haris-mujeeb/STM32-Drone-Controller/README.md

# 🚁 STM32 Drone Controller 🚀

A compact and robust drone flight controller designed with STM32 microcontroller and KiCad. This project focuses on providing a reliable hardware platform for custom drone builds and research.

## ✨ Features

*   **STM32 Microcontroller**: High-performance processing for flight control algorithms.
*   **BMI088 IMU**: Integrated 6-axis Inertial Measurement Unit for precise attitude estimation.
*   **KiCad Design**: Open-source hardware design files for easy modification and manufacturing.

## 🛠️ Technologies Used

*   **KiCad**: PCB design and schematic capture.
*   **STM32**: Embedded system development.
*   **BMI088**: Sensor integration.

## 📸 Visuals
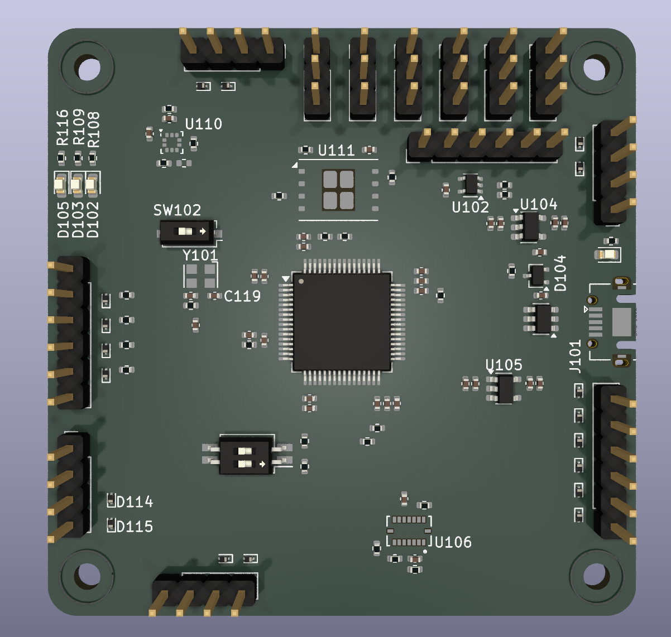
[picture p1: PCB_1.png]


## 📍Pinout
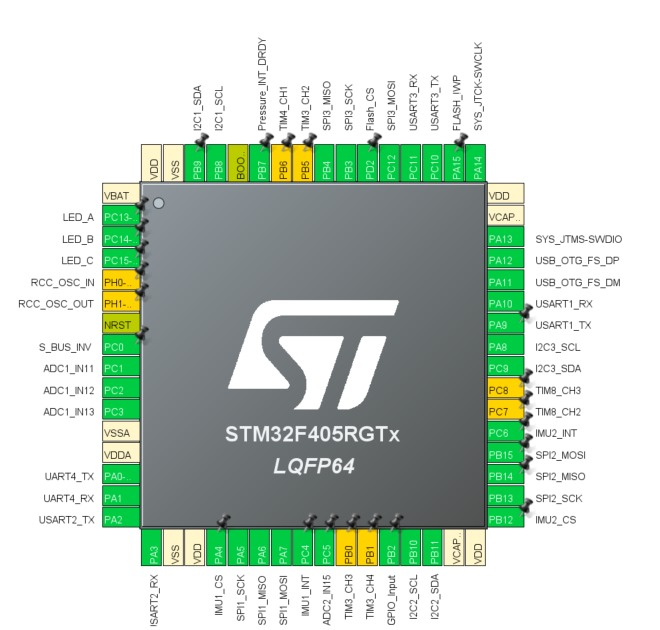
[picture p2: STM32 Pinout.jpg]
STM32 Drone Controller Pinout


## 📄Schematic
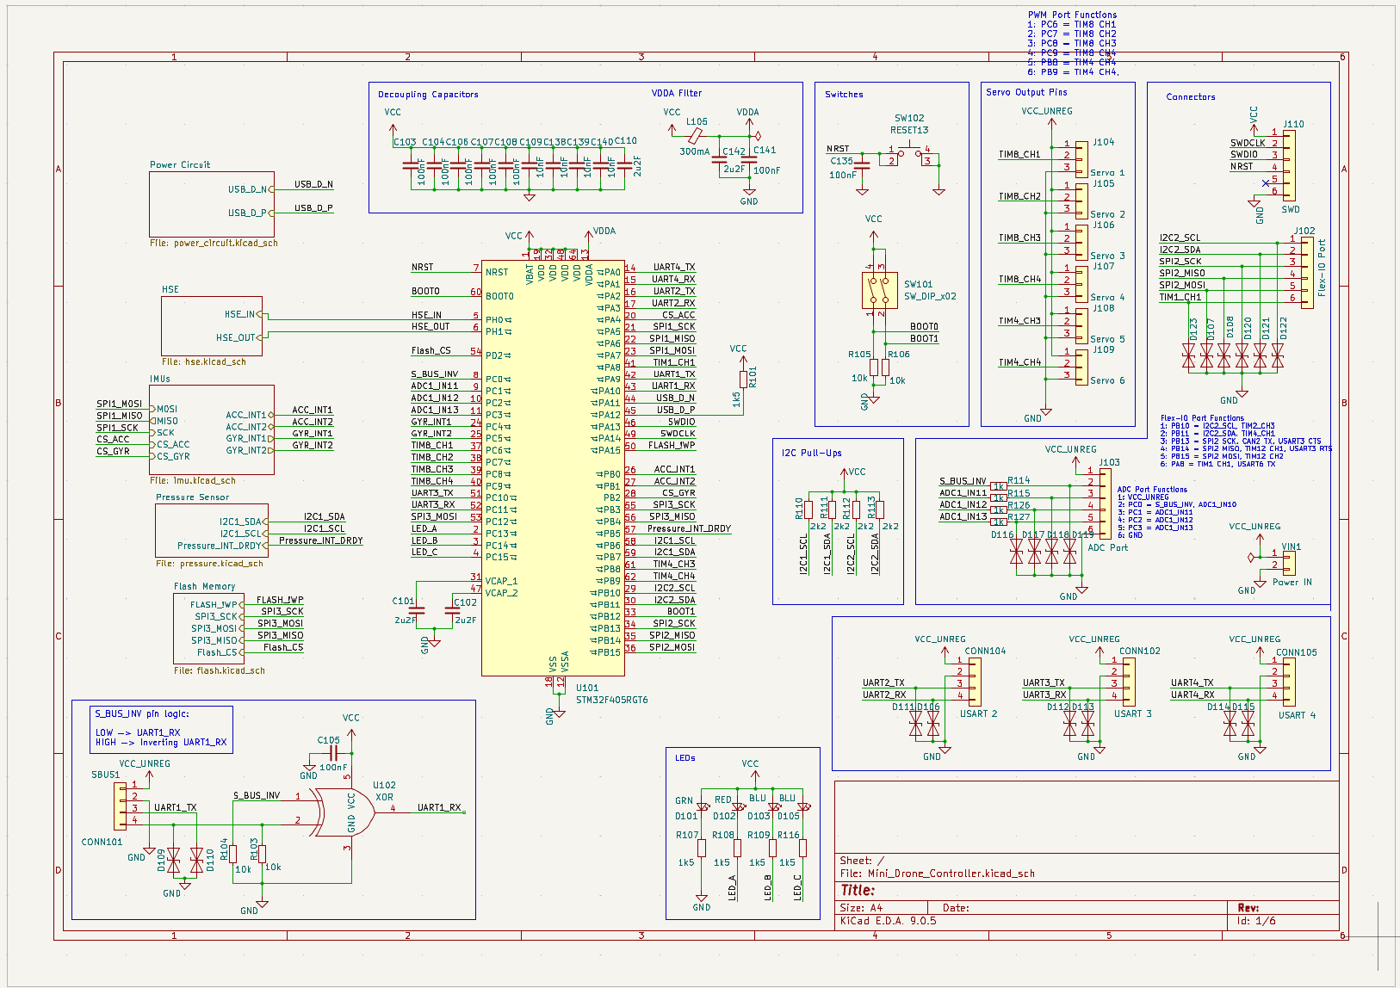
[picture p3: Schematic.png]
STM32 Drone Controller Schematic


## 📂 Project Structure

The repository contains all necessary KiCad project files, component libraries, and documentation.
