haris-mujeeb/STM32-Drone-Controller/Components/BMI088/BMI088.step

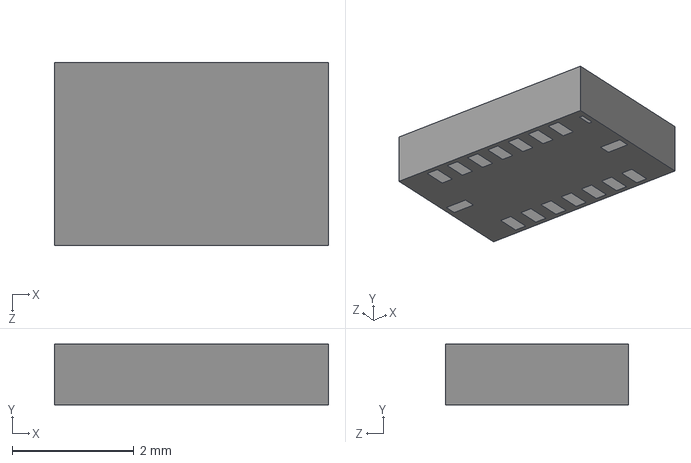
[picture p4: CAD file, 2025-10-25]
Components/BMI088/BMI088.step
4.50 x 1.00 x 3.00 mm
