haris-mujeeb/STM32-Drone-Controller/Mini_Drone_Controller.kicad_pcb

## KiCad design Mini_Drone_Controller.kicad_pcb (2025-10-25)

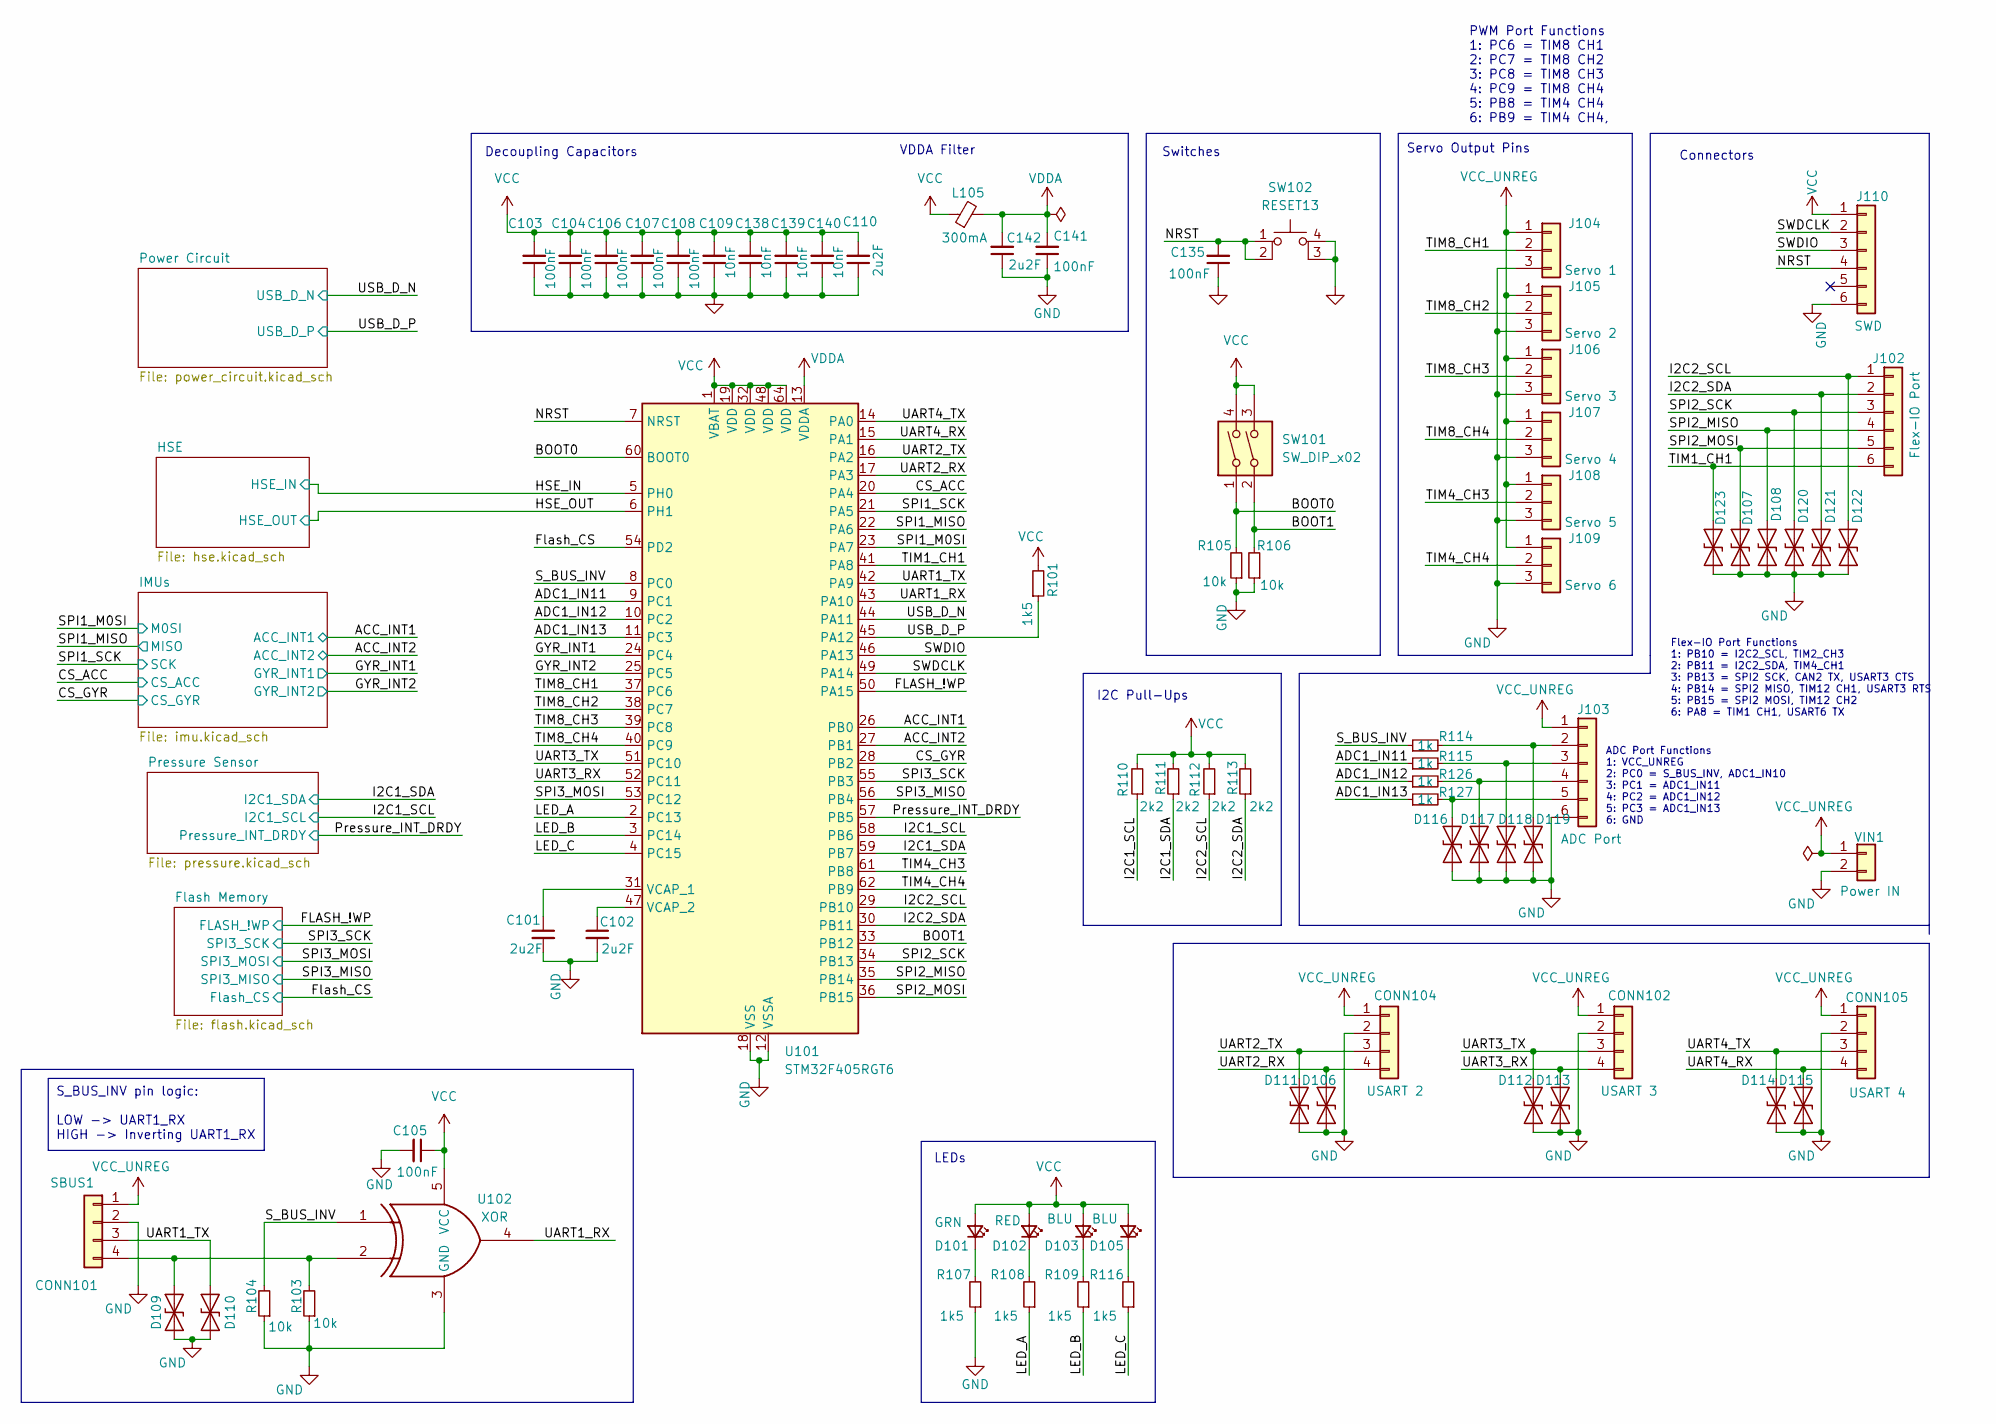
[picture p5: schematic Mini_Drone_Controller.kicad_sch]

Parts:
C101, C102, C110, C142: 2u2F; C_0402_1005Metric; Mfr. # CL05A225MQ5NSNC
C103, C104, C105, C106, C107, C108, C135, C141: 100nF; C_0402_1005Metric; Mfr. # CL05B104KO5NNNC
C109, C138, C139, C140: 10nF; C_0402_1005Metric; Mfr. # CL05B103KB5NNNC
CONN101: SBUS1; PinHeader_1x04_P2.54mm_Vertical; Mfr. # HB-PH3-25414PB2GOP
CONN102: USART 3; PinHeader_1x04_P2.54mm_Vertical; Mfr. # HB-PH3-25414PB2GOP
CONN104: USART 2; PinHeader_1x04_P2.54mm_Vertical; Mfr. # HB-PH3-25414PB2GOP
CONN105: USART 4; PinHeader_1x04_P2.54mm_Vertical; Mfr. # HB-PH3-25414PB2GOP
D101: GRN; LED_0603_1608Metric; Mfr. # PSC-1608U52GC-G4
D102: RED; LED_0603_1608Metric; Mfr. # XL-1608SURC-06
D103, D105: BLU; LED_0603_1608Metric; Mfr. # XL-1608UBC-04
D106, D107, D108, D109, D110, D111, D112, D113, D114, D115, D116, D117, D118, D119, D120, D121, D122, D123: ESD9B3.3ST5G; D_SOD-923; Mfr. # ESD9B3.3ST5G
J102: Flex-IO Port; PinHeader_1x06_P2.54mm_Vertical; Mfr. # PZ254V-11-06P
J103: ADC Port; PinHeader_1x06_P2.54mm_Vertical; Mfr. # PZ254V-11-06P
J104: Servo 1; PinHeader_1x03_P2.54mm_Vertical; Mfr. # 2.54-1*3P
J105: Servo 2; PinHeader_1x03_P2.54mm_Vertical; Mfr. # 2.54-1*3P
J106: Servo 3; PinHeader_1x03_P2.54mm_Vertical; Mfr. # 2.54-1*3P
J107: Servo 4; PinHeader_1x03_P2.54mm_Vertical; Mfr. # 2.54-1*3P
J108: Servo 5; PinHeader_1x03_P2.54mm_Vertical; Mfr. # 2.54-1*3P
J109: Servo 6; PinHeader_1x03_P2.54mm_Vertical; Mfr. # 2.54-1*3P
J110: SWD; PinHeader_1x06_P2.54mm_Vertical; Mfr. # PZ254V-11-06P
L105: 300mA; R_0402_1005Metric; Mfr. # BLM15AG102SN1D
R101, R107, R108, R109, R116: 1k5; R_0402_1005Metric; Mfr. # RC0402FR-071K5L
R103, R104, R105, R106: 10k; R_0402_1005Metric; Mfr. # RC0402FR-0710KL
R110, R111, R112, R113: 2k2; R_0402_1005Metric; Mfr. # RC0402FR-072K2L
R114, R115, R126, R127: 1k; R_0402_1005Metric; Mfr. # RC0402FR-071KL
SW101: SW_DIP_x02; SW_DIP_SPSTx02_Slide_Copal_CHS-02B_W7.62mm_P1.27mm; Mfr. # DSHP02TSGET
SW102: RESET13; SW_DIP_SPSTx01_Slide_Copal_CHS-01A_W5.08mm_P1.27mm_JPin; Mfr. # TS-1088-AR02016
U101: STM32F405RGT6; LQFP-64_10x10mm_P0.5mm; Mfr. # STM32F405RGT6
U102: XOR; SOT-353_SC-70-5; Mfr. # SN74LVC1G86DCKR
VIN1: Power IN; PinHeader_1x02_P2.54mm_Vertical; Mfr. # PZ254V-11-02P

Connections:
/ACC_INT1: U101.26 (PB0); also elsewhere on the board
/ACC_INT2: U101.27 (PB1); also elsewhere on the board
/ADC1_IN11: R115.1, U101.9 (PC1)
/ADC1_IN12: R126.1, U101.10 (PC2)
/ADC1_IN13: R127.1, U101.11 (PC3)
/BOOT0: R105.2, SW101.1, U101.60 (BOOT0)
/BOOT1: R106.2, SW101.2, U101.33 (PB12)
/CS_ACC: U101.20 (PA4); also elsewhere on the board
/CS_GYR: U101.28 (PB2); also elsewhere on the board
/FLASH_!WP: U101.50 (PA15); also elsewhere on the board
/Flash_CS: U101.54 (PD2); also elsewhere on the board
/GYR_INT1: U101.24 (PC4); also elsewhere on the board
/GYR_INT2: U101.25 (PC5); also elsewhere on the board
/HSE_IN: U101.5 (PH0); also elsewhere on the board
/HSE_OUT: U101.6 (PH1); also elsewhere on the board
/I2C1_SCL: R110.1, U101.58 (PB6); also elsewhere on the board
/I2C1_SDA: R111.1, U101.59 (PB7); also elsewhere on the board
/I2C2_SCL: D122.2 (A2), J102.1, R112.1, U101.29 (PB10)
/I2C2_SDA: D121.2 (A2), J102.2, R113.1, U101.30 (PB11)
/LED_A: R108.1, U101.2 (PC13)
/LED_B: R109.1, U101.3 (PC14)
/LED_C: R116.1, U101.4 (PC15)
/NRST: C135.2, J110.4, SW102.1, SW102.2, U101.7 (NRST)
/Pressure_INT_DRDY: U101.57 (PB5); also elsewhere on the board
/SPI1_M0SI: U101.23 (PA7); also elsewhere on the board
/SPI1_MISO: U101.22 (PA6); also elsewhere on the board
/SPI1_SCK: U101.21 (PA5); also elsewhere on the board
/SPI2_MISO: D108.2 (A2), J102.4, U101.35 (PB14)
/SPI2_MOSI: D107.2 (A2), J102.5, U101.36 (PB15)
/SPI2_SCK: D120.2 (A2), J102.3, U101.34 (PB13)
/SPI3_MISO: U101.56 (PB4); also elsewhere on the board
/SPI3_MOSI: U101.53 (PC12); also elsewhere on the board
/SPI3_SCK: U101.55 (PB3); also elsewhere on the board
/SWDCLK: J110.2, U101.49 (PA14)
/SWDIO: J110.3, U101.46 (PA13)
/S_BUS_INV: R104.2, R114.1, U101.8 (PC0), U102.1
/TIM1_CH1: D123.2 (A2), J102.6, U101.41 (PA8)
/TIM4_CH3: J108.2, U101.61 (PB8)
/TIM4_CH4: J109.2, U101.62 (PB9)
/TIM8_CH1: J104.2, U101.37 (PC6)
/TIM8_CH2: J105.2, U101.38 (PC7)
/TIM8_CH3: J106.2, U101.39 (PC8)
/TIM8_CH4: J107.2, U101.40 (PC9)
/UART1_RX: U101.43 (PA10), U102.4
/UART1_TX: CONN101.3, D110.2 (A2), U101.42 (PA9)
/UART2_RX: CONN104.4, D106.2 (A2), U101.17 (PA3)
/UART2_TX: CONN104.3, D111.2 (A2), U101.16 (PA2)
/UART3_RX: CONN102.4, D113.2 (A2), U101.52 (PC11)
/UART3_TX: CONN102.3, D112.2 (A2), U101.51 (PC10)
/UART4_RX: CONN105.4, D115.2 (A2), U101.15 (PA1)
/UART4_TX: CONN105.3, D114.2 (A2), U101.14 (PA0)
/USB_D_N: U101.44 (PA11); also elsewhere on the board
/USB_D_P: R101.1, U101.45 (PA12); also elsewhere on the board
GND: C101.2, C102.2, C103.1, C104.1, C105.2, C106.1, C107.1, C108.1, C109.1, C110.1, C135.1, C138.1, C139.1, C140.1, C141.1, C142.1, CONN101.2, CONN102.2, CONN104.2, CONN105.2, D106.1 (A1), D107.1 (A1), D108.1 (A1), D109.1 (A1), D110.1 (A1), D111.1 (A1), D112.1 (A1), D113.1 (A1), D114.1 (A1), D115.1 (A1), D116.1 (A1), D117.1 (A1), D118.1 (A1), D119.1 (A1), D120.1 (A1), D121.1 (A1), D122.1 (A1), D123.1 (A1), J103.6, J104.3, J105.3, J106.3, J107.3, J108.3, J109.3, J110.6, R103.1, R104.1, R105.1, R106.1, R107.1, SW102.3 (K), SW102.4 (A), U101.12 (VSSA), U101.18 (VSS), U101.63 (VSS), U102.3 (GND), VIN1.2; also elsewhere on the board
unnamed: CONN101.4, D109.2 (A2), R103.2, U102.2
unnamed: D101.1 (K), R107.2
unnamed: D102.1 (K), R108.2
unnamed: D103.1 (K), R109.2
unnamed: D105.1 (K), R116.2
unnamed: D116.2 (A2), J103.5, R127.2
unnamed: D117.2 (A2), J103.4, R126.2
unnamed: D118.2 (A2), J103.3, R115.2
unnamed: D119.2 (A2), J103.2, R114.2
unnamed: C101.1, U101.31 (VCAP_1)
unnamed: C102.1, U101.47 (VCAP_2)
VCC: C103.2, C104.2, C105.1, C106.2, C107.2, C108.2, C109.2, C110.2, C138.2, C139.2, C140.2, D101.2 (A), D102.2 (A), D103.2 (A), D105.2 (A), J110.1, L105.1, R101.2, R110.2, R111.2, R112.2, R113.2, SW101.3, SW101.4, U101.1 (VBAT), U101.19 (VDD), U101.32 (VDD), U101.48 (VDD), U101.64 (VDD), U102.5 (VCC); also elsewhere on the board
VCC_UNREG: CONN101.1, CONN102.1, CONN104.1, CONN105.1, J103.1, J104.1, J105.1, J106.1, J107.1, J108.1, J109.1, VIN1.1; also elsewhere on the board
VDDA: C141.2, C142.2, L105.2, U101.13 (VDDA)

Notes on the sheet:
S_BUS_INV pin logic: LOW -> UART1_RX HIGH -> Inverting UART1_RX
LEDs
Switches
Connectors
Decoupling Capacitors
VDDA Filter
Flex-IO Port Functions 1: PB10 = I2C2_SCL, TIM2_CH3 2: PB11 = I2C2_SDA, TIM4_CH1 3: PB13 = SPI2 SCK, CAN2 TX, USART3 CTS 4: PB14 = SPI2 MISO, TIM12 CH1, USART3 RTS 5: PB15 = SPI2 MOSI, TIM12 CH2 6: PA8 = TIM1 CH1, USART6 TX
I2C Pull-Ups
PWM Port Functions 1: PC6 = TIM8 CH1 2: PC7 = TIM8 CH2 3: PC8 = TIM8 CH3 4: PC9 = TIM8 CH4 5: PB8 = TIM4 CH4 6: PB9 = TIM4 CH4,
ADC Port Functions 1: VCC_UNREG 2: PC0 = S_BUS_INV, ADC1_IN10 3: PC1 = ADC1_IN11 4: PC2 = ADC1_IN12 5: PC3 = ADC1_IN13 6: GND
Servo Output Pins

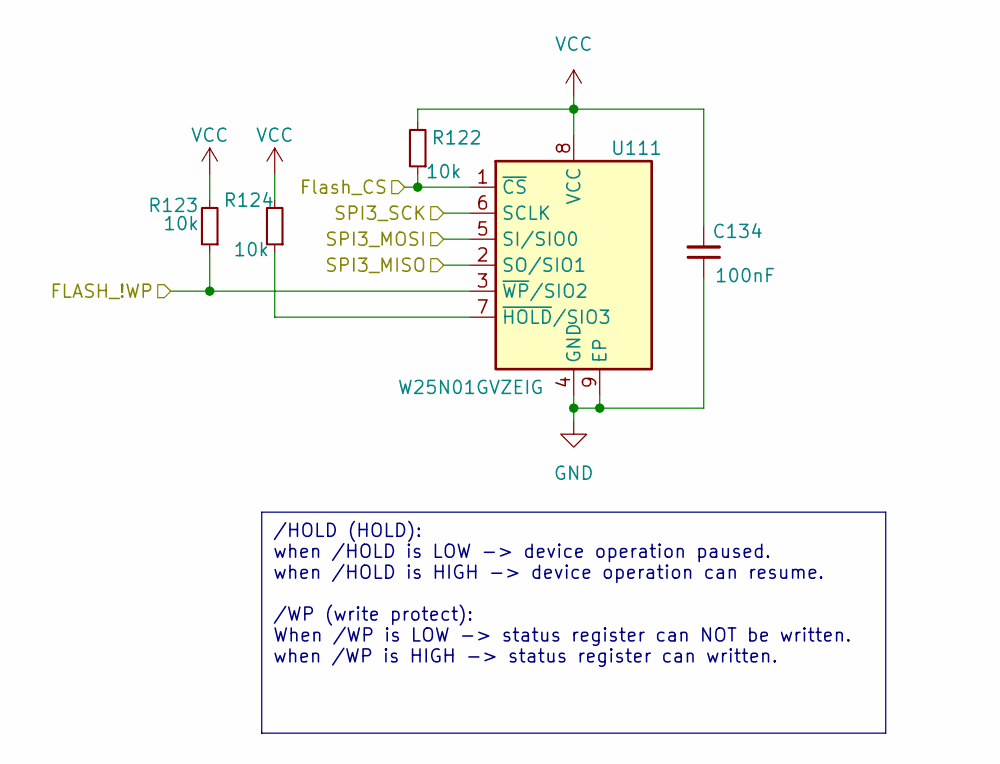
[picture p6: schematic flash.kicad_sch]

Parts:
C134: 100nF; C_0402_1005Metric; Mfr. # CL05B104KO5NNNC
R122, R123, R124: 10k; R_0402_1005Metric; Mfr. # RC0402FR-0710KL
U111: W25N01GVZEIG; WSON-8-1EP_8x6mm_P1.27mm_EP3.4x4.3mm; Mfr. # W25N01GVZEIG

Connections:
/FLASH_!WP: R123.1, U111.3 (~WP/SIO2); also elsewhere on the board
/Flash_CS: R122.1, U111.1 (~CS); also elsewhere on the board
/SPI3_MISO: U111.2 (SO/SIO1); also elsewhere on the board
/SPI3_MOSI: U111.5 (SI/SIO0); also elsewhere on the board
/SPI3_SCK: U111.6 (SCLK); also elsewhere on the board
GND: C134.1, U111.4 (GND), U111.9 (EP); also elsewhere on the board
unnamed: R124.1, U111.7 (~HOLD/SIO3)
VCC: C134.2, R122.2, R123.2, R124.2, U111.8 (VCC); also elsewhere on the board

Notes on the sheet:
/HOLD (HOLD): when /HOLD is LOW -> device operation paused. when /HOLD is HIGH -> device operation can resume. /WP (write protect): When /WP is LOW -> status register can NOT be written. when /WP is HIGH -> status register can written.

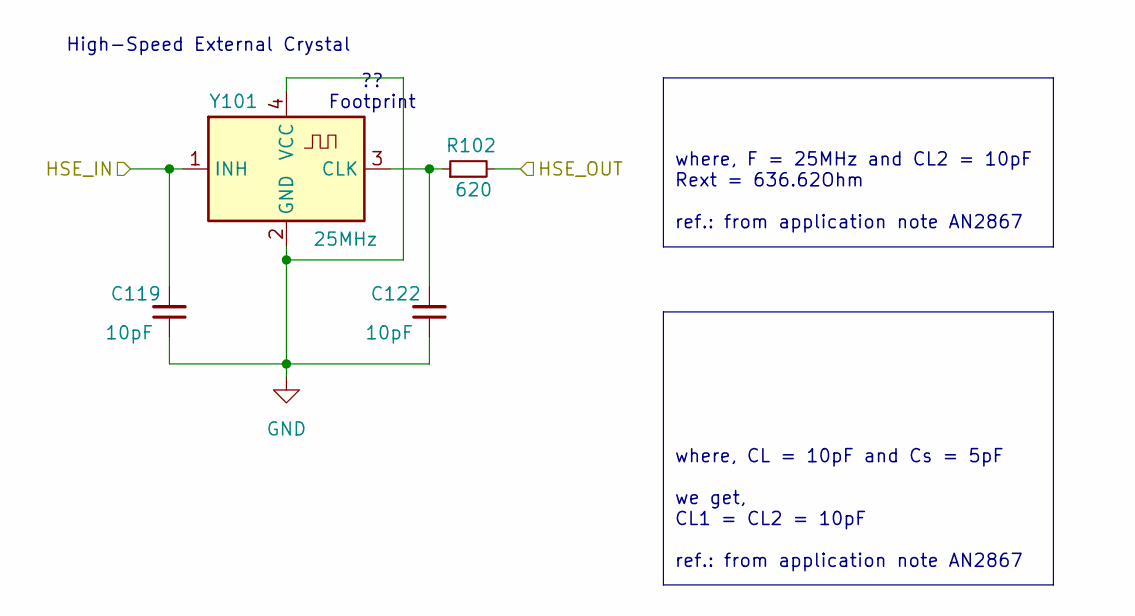
[picture p7: schematic hse.kicad_sch]

Parts:
C119, C122: 10pF; C_0402_1005Metric; Mfr. # CL05C100JB5NNNC
R102: 620; R_0402_1005Metric; Mfr. # RC0402FR-07620RL
Y101: 25MHz; Oscillator_SMD_Kyocera_KC2520Z-4Pin_2.5x2.0mm; Mfr. # X322525MSB4SI

Connections:
/HSE_IN: C119.2, Y101.1 (INH); also elsewhere on the board
/HSE_OUT: R102.2; also elsewhere on the board
GND: C119.1, C122.1, Y101.2 (GND), Y101.4 (VCC); also elsewhere on the board
unnamed: C122.2, R102.1, Y101.3 (CLK)

Notes on the sheet:
where, CL = 10pF and Cs = 5pF we get, CL1 = CL2 = 10pF ref.: from application note AN2867
where, F = 25MHz and CL2 = 10pF Rext = 636.62Ohm ref.: from application note AN2867
?? Footprint
High-Speed External Crystal

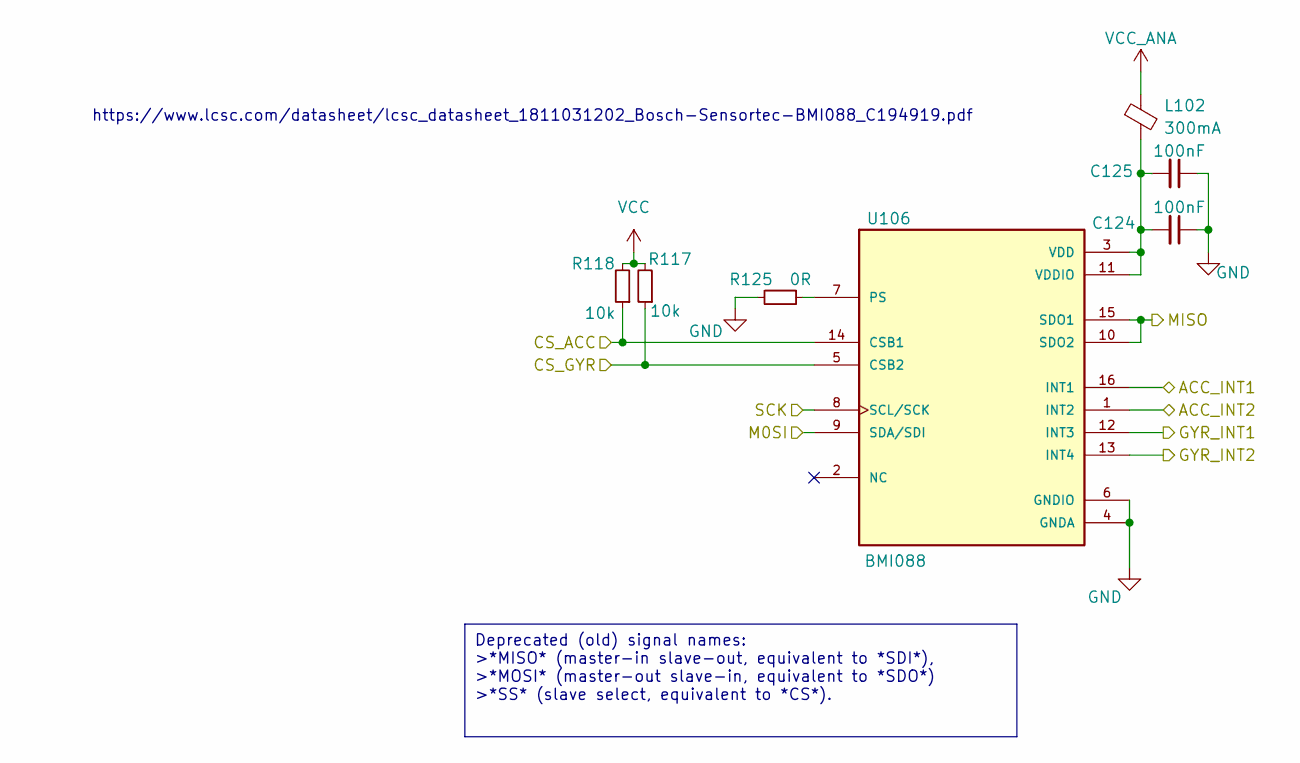
[picture p8: schematic imu.kicad_sch]

Parts:
C124, C125: 100nF; C_0402_1005Metric; Mfr. # CL05B104KO5NNNC
L102: 300mA; R_0402_1005Metric; Mfr. # BLM15AG102SN1D
R117, R118: 10k; R_0402_1005Metric; Mfr. # RC0402FR-0710KL
R125: 0R; R_0402_1005Metric; Mfr. # RC0402JR-070RL
U106: BMI088; PQFN50P450X300X100-16N; Mfr. # BMI088

Connections:
/ACC_INT1: U106.16 (INT1); also elsewhere on the board
/ACC_INT2: U106.1 (INT2); also elsewhere on the board
/CS_ACC: R118.1, U106.14 (CSB1); also elsewhere on the board
/CS_GYR: R117.1, U106.5 (CSB2); also elsewhere on the board
/GYR_INT1: U106.12 (INT3); also elsewhere on the board
/GYR_INT2: U106.13 (INT4); also elsewhere on the board
/SPI1_M0SI: U106.9 (SDA/SDI); also elsewhere on the board
/SPI1_MISO: U106.10 (SDO2), U106.15 (SDO1); also elsewhere on the board
/SPI1_SCK: U106.8 (SCL/SCK); also elsewhere on the board
GND: C124.1, C125.1, R125.2, U106.4 (GNDA), U106.6 (GNDIO); also elsewhere on the board
unnamed: R125.1, U106.7 (PS)
unnamed: C124.2, C125.2, L102.2, U106.3 (VDD), U106.11 (VDDIO)
VCC: R117.2, R118.2; also elsewhere on the board
VCC_ANA: L102.1; also elsewhere on the board

Notes on the sheet:
Deprecated (old) signal names: >*MISO* (master-in slave-out, equivalent to *SDI*), >*MOSI* (master-out slave-in, equivalent to *SDO*) >*SS* (slave select, equivalent to *CS*).
https://www.lcsc.com/datasheet/lcsc_datasheet_1811031202_Bosch-Sensortec-BMI088_C194919.pdf

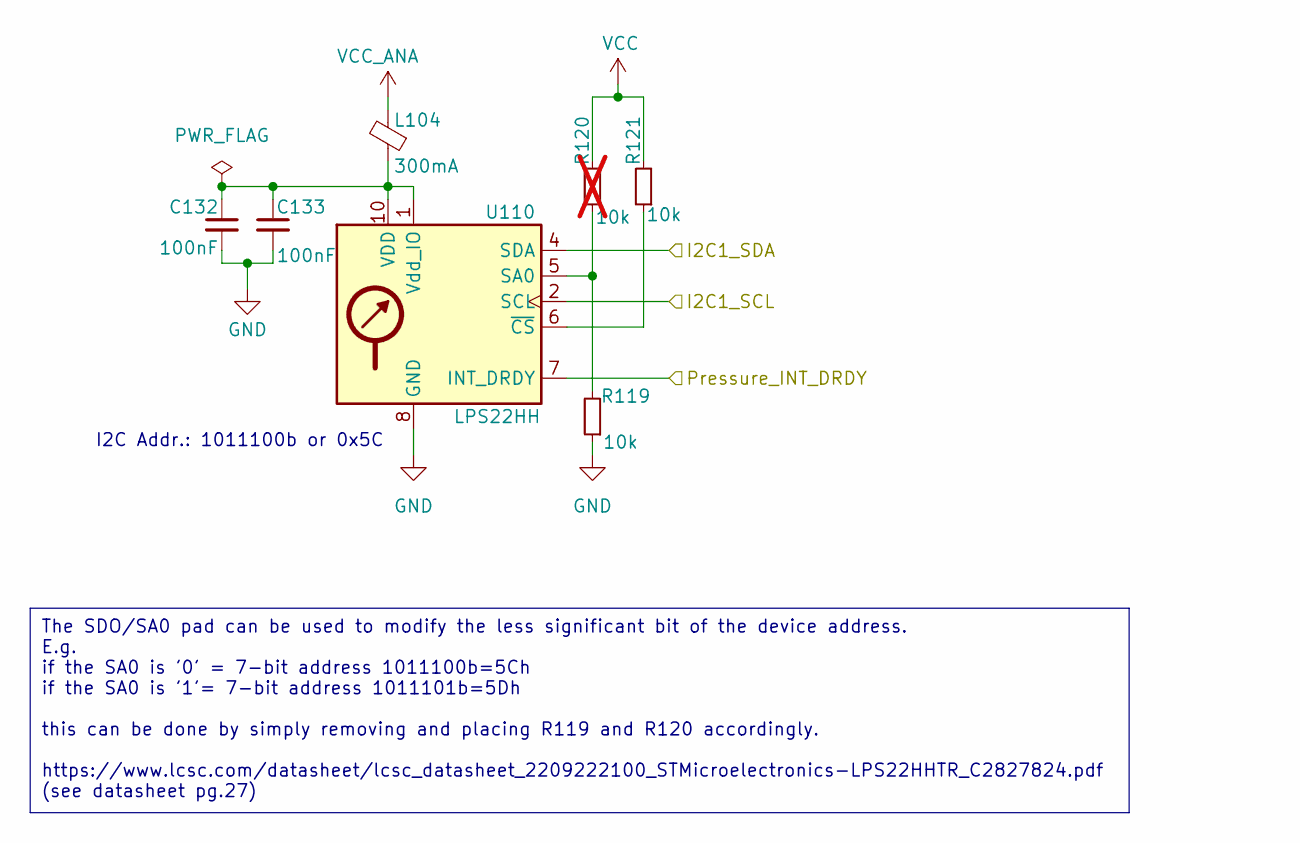
[picture p9: schematic pressure.kicad_sch]

Parts:
C132, C133: 100nF; C_0402_1005Metric; Mfr. # CL05B104KO5NNNC
L104: 300mA; R_0402_1005Metric; Mfr. # BLM15AG102SN1D
R119, R121: 10k; R_0402_1005Metric; Mfr. # RC0402FR-0710KL
R120: 10k; R_0402_1005Metric; Mfr. # RC0402FR-0710KL; not fitted
U110: LPS22HH; ST_HLGA-10_2x2mm_P0.5mm_LayoutBorder3x2y; Mfr. # LPS22HHTR

Connections:
/I2C1_SCL: U110.2 (SCL); also elsewhere on the board
/I2C1_SDA: U110.4 (SDA); also elsewhere on the board
/Pressure_INT_DRDY: U110.7 (INT_DRDY); also elsewhere on the board
GND: C132.2, C133.2, R119.1, U110.3 (GND), U110.8 (GND), U110.9 (GND); also elsewhere on the board
unnamed: R119.2, R120.1, U110.5 (SA0)
unnamed: C132.1, C133.1, L104.1, U110.1 (Vdd_IO), U110.10 (VDD)
unnamed: R121.1, U110.6 (~CS)
VCC: R120.2, R121.2; also elsewhere on the board
VCC_ANA: L104.2; also elsewhere on the board

Notes on the sheet:
The SDO/SA0 pad can be used to modify the less significant bit of the device address. E.g. if the SA0 is '0' = 7-bit address 1011100b=5Ch if the SA0 is '1'= 7-bit address 1011101b=5Dh this can be done by simply removing and placing R119 and R120 accordingly. https://www.lcsc.com/datasheet/lcsc_data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
I2C Addr.: 1011100b or 0x5C

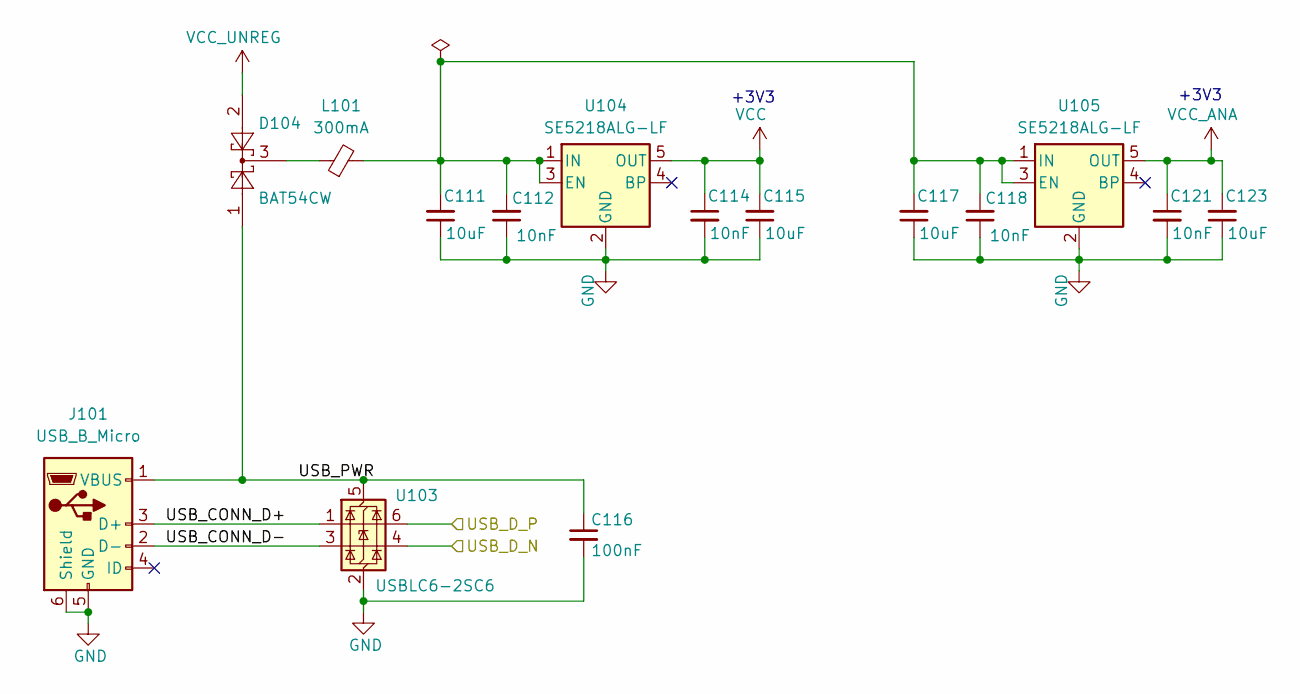
[picture p10: schematic power_circuit.kicad_sch]

Parts:
C111, C115, C117, C123: 10uF; C_0402_1005Metric; Mfr. # CL05A106MQ5NUNC
C112, C114, C118, C121: 10nF; C_0402_1005Metric; Mfr. # CL05B103KB5NNNC
C116: 100nF; C_0402_1005Metric; Mfr. # CL05B104KO5NNNC
D104: BAT54CW; SOT-323_SC-70
J101: USB_B_Micro; USB_Micro-AB_Molex_47590-0001; Mfr. # 475900001
L101: 300mA; R_0402_1005Metric; Mfr. # BLM15AG102SN1D
U103: USBLC6-2SC6; SOT-23-6; Mfr. # USBLC6-2SC6
U104, U105: SE5218ALG-LF; SOT-23-5; Mfr. # SE5218ALG-LF

Connections:
/Power Circuit/USB_CONN_D+: J101.3 (D+), U103.1 (I/O1)
/Power Circuit/USB_CONN_D-: J101.2 (D-), U103.3 (I/O2)
/Power Circuit/USB_PWR: C116.1, D104.1, J101.1 (VBUS), U103.5 (VBUS)
/USB_D_N: U103.4 (I/O2); also elsewhere on the board
/USB_D_P: U103.6 (I/O1); also elsewhere on the board
GND: C111.1, C112.1, C114.2, C115.1, C116.2, C117.1, C118.1, C121.2, C123.1, J101.5 (GND), J101.6 (Shield), U103.2 (GND), U104.2 (GND), U105.2 (GND); also elsewhere on the board
unnamed: D104.3, L101.1
unnamed: C111.2, C112.2, C117.2, C118.2, L101.2, U104.1 (IN), U104.3 (EN), U105.1 (IN), U105.3 (EN)
VCC: C114.1, C115.2, U104.5 (OUT); also elsewhere on the board
VCC_ANA: C121.1, C123.2, U105.5 (OUT); also elsewhere on the board
VCC_UNREG: D104.2; also elsewhere on the board

Notes on the sheet:
+3V3

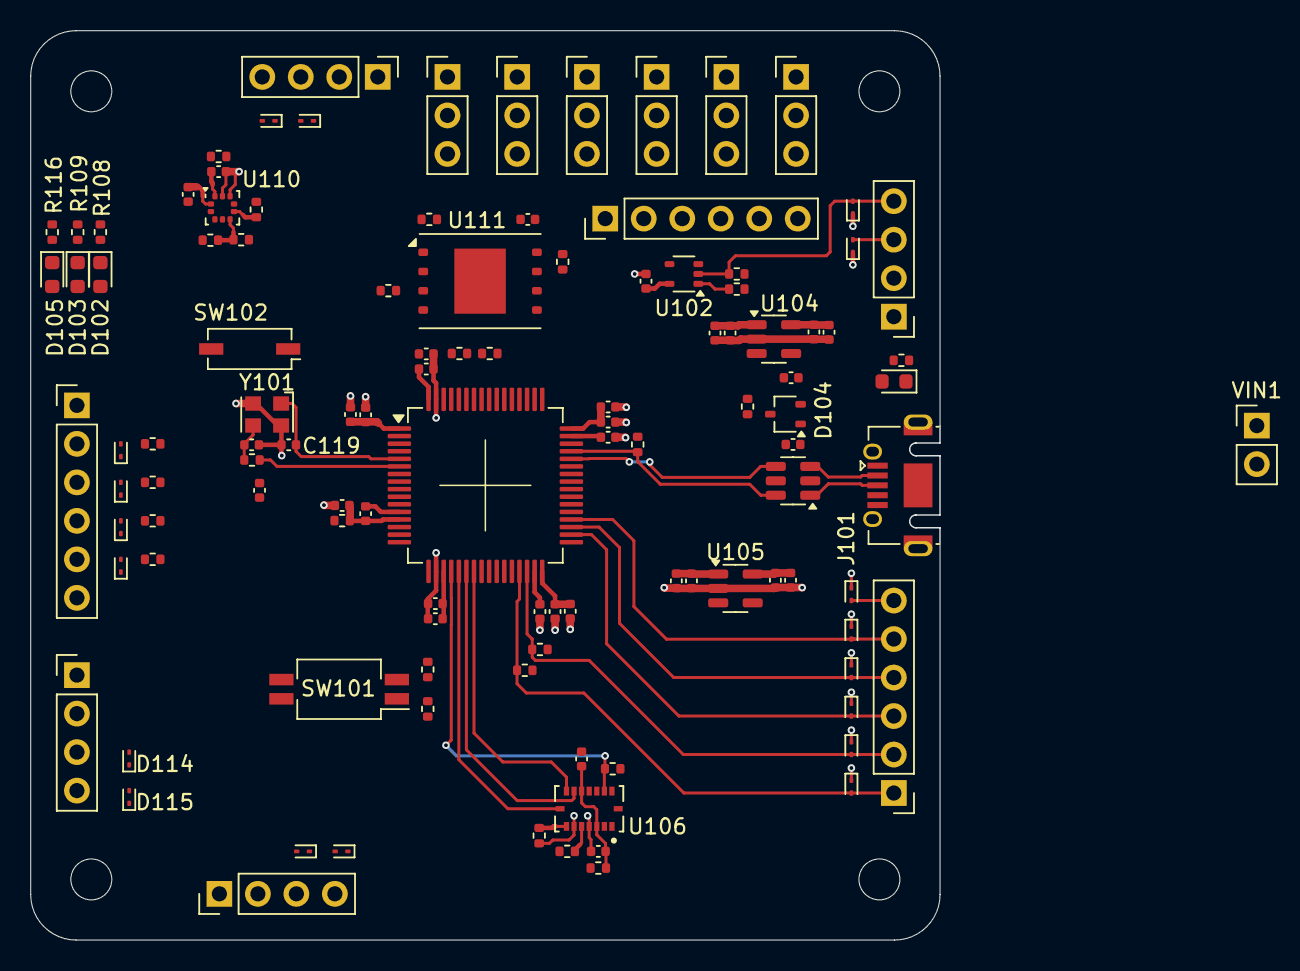
[picture p11: board Mini_Drone_Controller.kicad_pcb from above]

Board: 4 copper layers, 60.0 x 60.0 mm, 113 parts (0 on the bottom side), 81 nets.

Other parts of the board:
C113: 10nF; C_0402_1005Metric

Their connections:
GND: C113.1; also elsewhere on the board
